LesterCovata/Tplain/Hardware/Schematics/VK3PE Schematics/TTGO_VFO_VK3PE_080819_Sch_V1_sheet_1.jpg

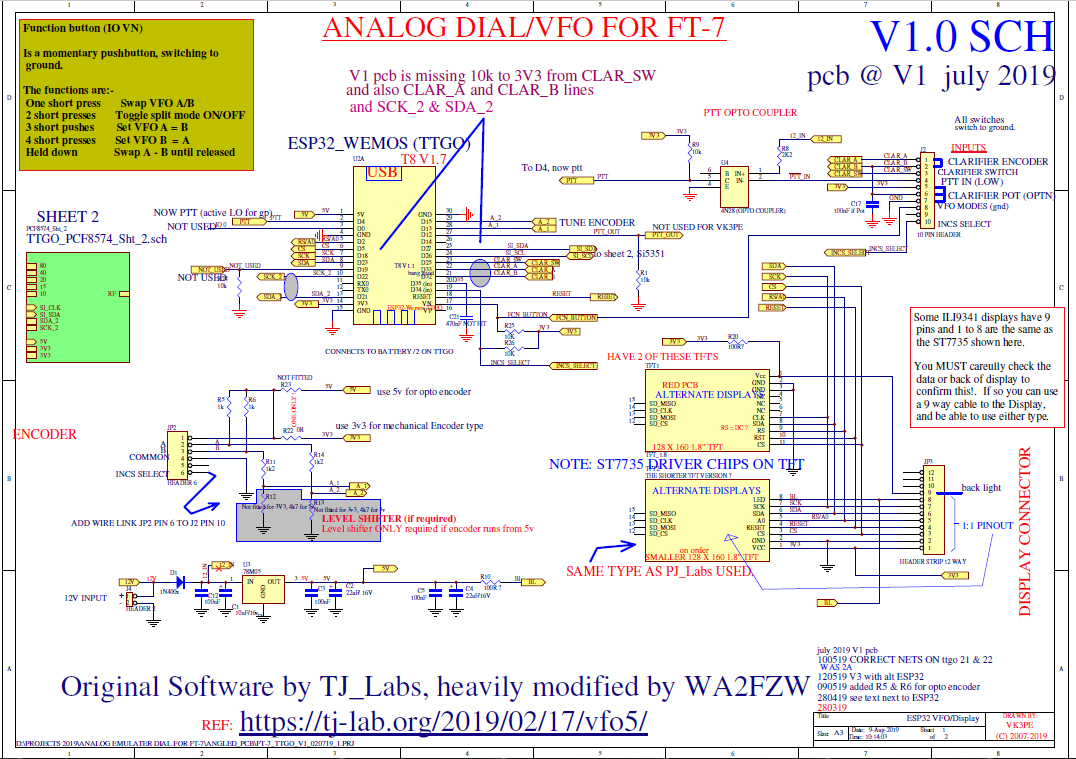
Hardware/Schematics/VK3PE Schematics/TTGO_VFO_VK3PE_080819_Sch_V1_sheet_1.jpg
