LesterCovata/Tplain/Hardware/Schematics/WA2FZW Schematics/Mode Select Button.jpg

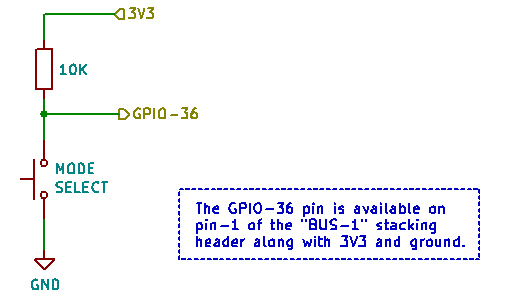
Hardware/Schematics/WA2FZW Schematics/Mode Select Button.jpg
