LesterCovata/Tplain/Hardware/Schematics/WA2FZW Schematics/PCF8574 Board Schematic.jpg

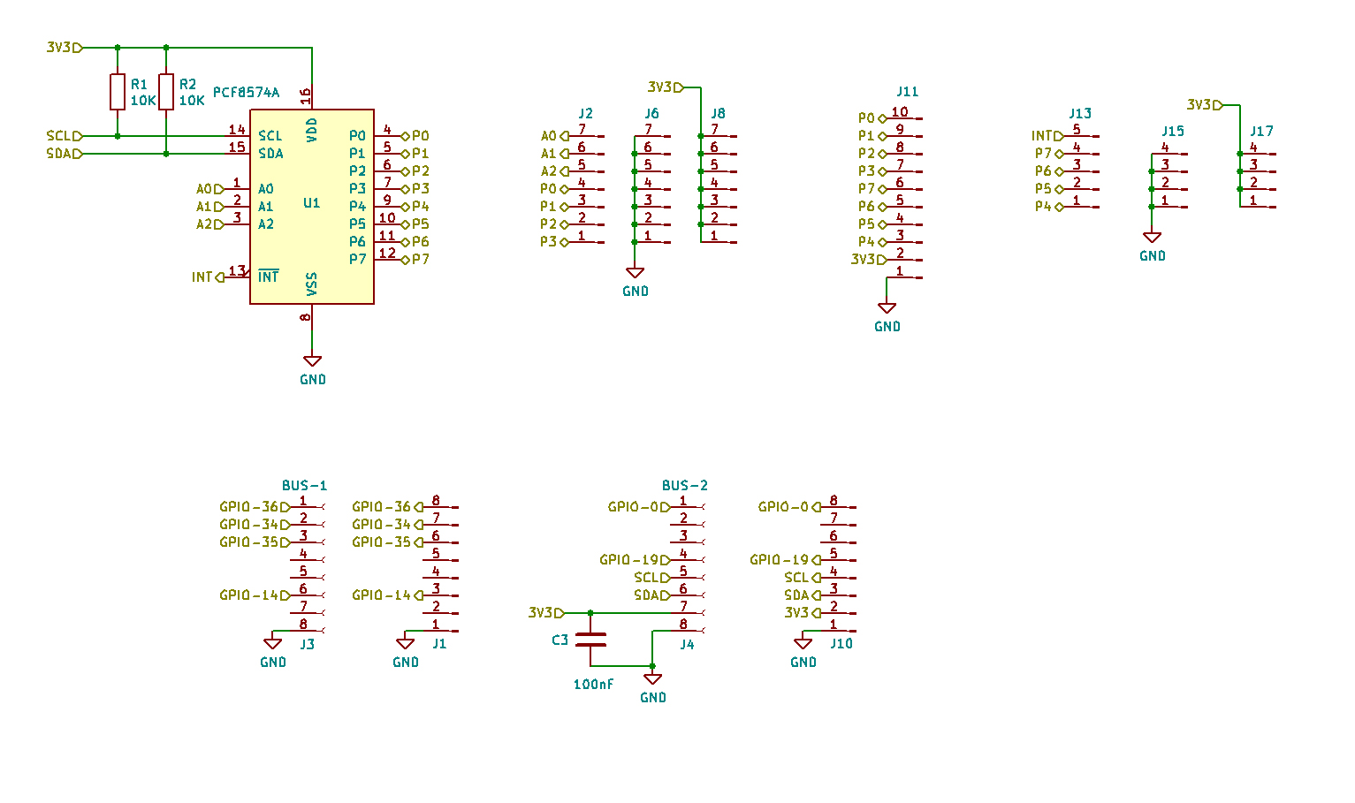
Hardware/Schematics/WA2FZW Schematics/PCF8574 Board Schematic.jpg
