LesterCovata/Tplain/Hardware/Schematics/WA2FZW Schematics/Processor Board Schematic.jpg

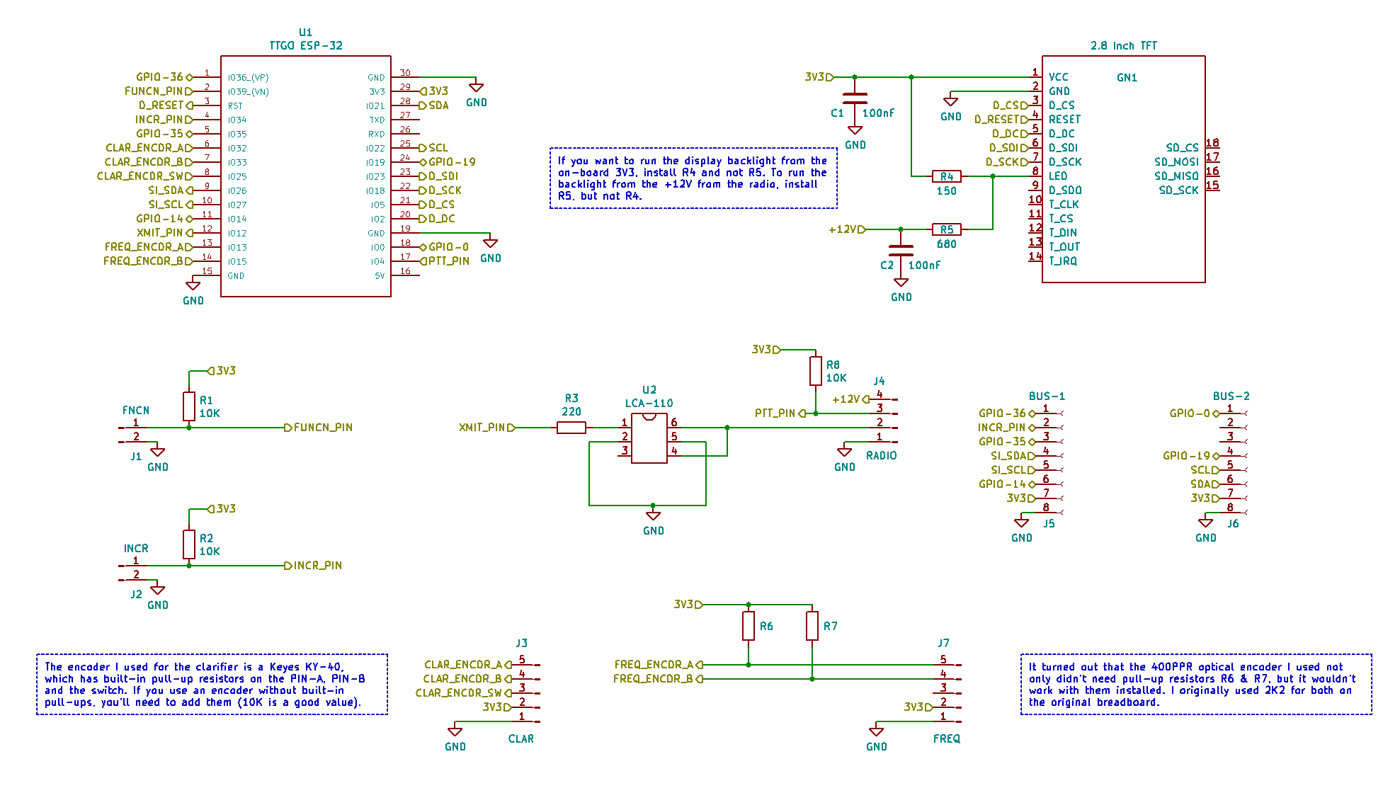
Hardware/Schematics/WA2FZW Schematics/Processor Board Schematic.jpg
