LesterCovata/Tplain/Hardware/Schematics/WA2FZW Schematics/PTT Circuit.jpg

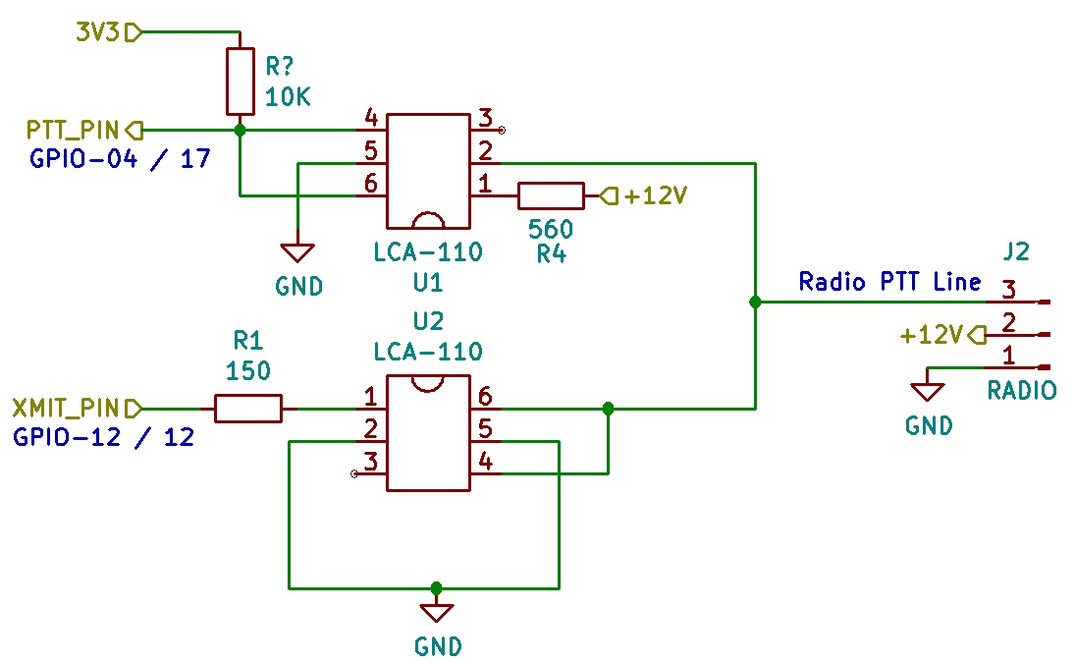
Hardware/Schematics/WA2FZW Schematics/PTT Circuit.jpg
