LesterCovata/Tplain/Hardware/Schematics/WA2FZW Schematics/RF Board Schematic.jpg

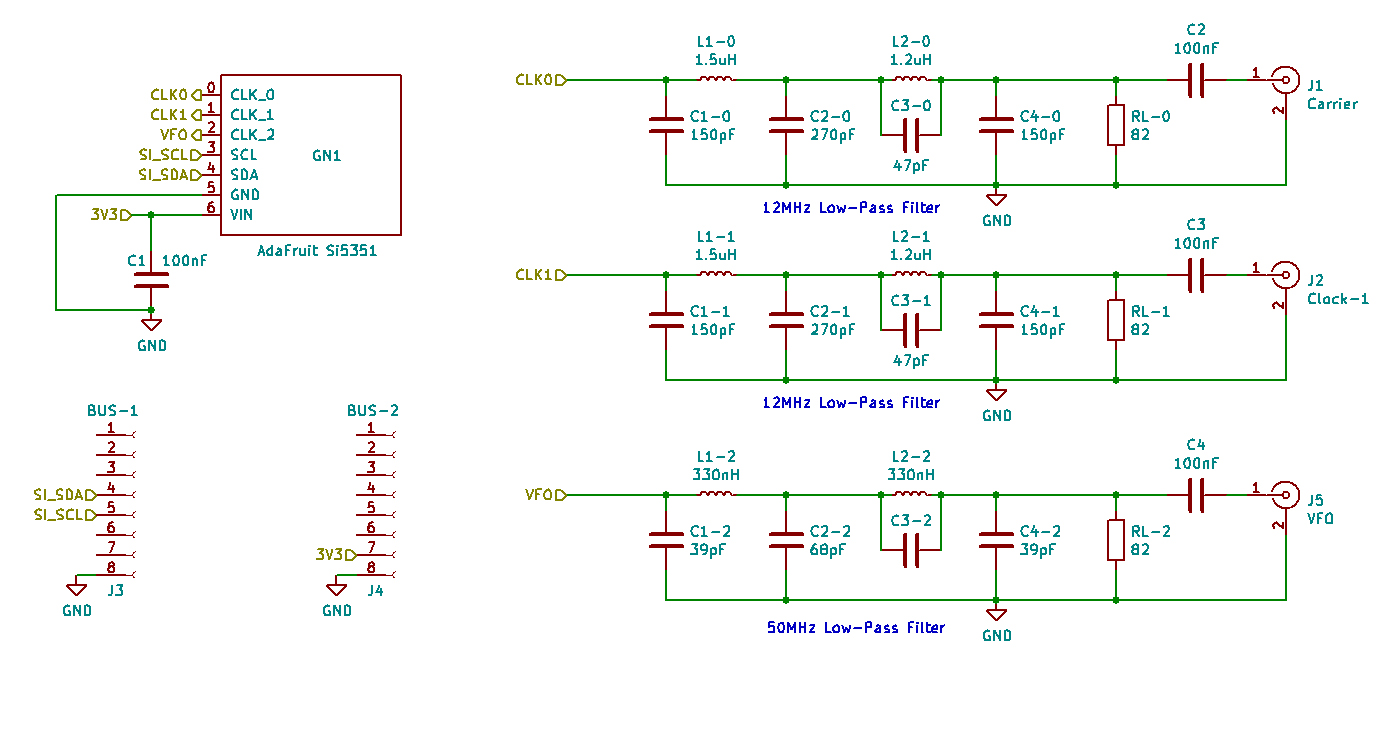
Hardware/Schematics/WA2FZW Schematics/RF Board Schematic.jpg
