LesterCovata/Tplain/NJAD_VFO_V1.1/dial_font.h

/* 
 *	"dial_font.h"
 *
 *	This is one of several files that define the various fonts used throughout the
 *	program and is TJ Uebo's code and not modified.
 */

#ifndef _DIAL_FONT_
#define _DIAL_FONT_          
            
const int Dial_font16[10][13] =
{
    {0x000007E0, 0x00001FF8, 0x0000381C, 0x00002004, 0x00002004, 0x0000381C, 0x00001FF8, 0x000007E0, 0,0,0,0,0}, 
    {0x00000000, 0x00001004, 0x00001004, 0x00003FFC, 0x00003FFC, 0x00000004, 0x00000004, 0x00000000, 0,0,0,0,0}, 
    {0x00000C1C, 0x00001C3C, 0x00003064, 0x000020C4, 0x00002184, 0x0000330C, 0x00001E3C, 0x00000C30, 0,0,0,0,0}, 
    {0x00000830, 0x00001838, 0x0000310C, 0x00002104, 0x00002104, 0x0000338C, 0x00001EF8, 0x00000C70, 0,0,0,0,0}, 
    {0x00000060, 0x000001E0, 0x000007A0, 0x00001E20, 0x00003824, 0x00003FFC, 0x00003FFC, 0x00000024, 0,0,0,0,0}, 
    {0x00000010, 0x00003F18, 0x00003F0C, 0x00002204, 0x00002204, 0x0000230C, 0x000021F8, 0x000020F0, 0,0,0,0,0}, 
    {0x00000FF0, 0x00001FF8, 0x0000330C, 0x00002204, 0x00002204, 0x0000330C, 0x000019F8, 0x000008F0, 0,0,0,0,0}, 
    {0x00000C00, 0x00003C00, 0x00003000, 0x0000203C, 0x000021FC, 0x000027C0, 0x00003E00, 0x00003800, 0,0,0,0,0}, 
    {0x00000C70, 0x00001EF8, 0x0000338C, 0x00002104, 0x00002104, 0x0000338C, 0x00001EF8, 0x00000C70, 0,0,0,0,0}, 
    {0x00000F10, 0x00001F98, 0x000030CC, 0x00002044, 0x00002044, 0x000030CC, 0x00001FF8, 0x00000FF0, 0,0,0,0,0}
};


const int Dial_font14[10][13]={
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
    {0x00000000, 0x000007CC, 0x00000FE6, 0x00000C66, 0x00000C66, 0x00000FFE, 0x000007FC, 0x00000000, 0x00000000, 0x00000000, 0x00000000, 0x00000000, 0 } 
};

#endif
