LesterCovata/Tplain/NJAD_VFO_V1.1/dial.h

/*
 *	"dial.h"
 *
 *	"dial.h" contains the function prototypes for dial.cpp. This is TJ Uebo's original
 *	unmodified other than cleaning up the formatting.
 */

#ifndef _DIAL_H_
#define	_DIAL_H_

void InitDial ( void );
void Dial ( long freq );
void dot( float, float );

void Sel_font12 ( void );
void Sel_font14 ( void );
void Sel_font16 ( void );

#endif							//_DIAL_H_
